DevOnichan/IoT-Based-Water-Quality/README.md

# 🐟 ระบบตรวจวัดคุณภาพน้ำสำหรับบ่อเลี้ยงปลาสลิดด้วยเทคโนโลยี IoT

## 📖 ความเป็นมาของโครงการ
โครงการนี้เริ่มต้นขึ้นเพื่อแก้ปัญหาในพื้นที่จังหวัดสมุทรสงคราม ซึ่งมีการเพาะเลี้ยงปลาสลิดเป็นจำนวนมาก แหล่งน้ำแต่ละบ่อมีสภาพแวดล้อมที่แตกต่างกันและอาจเกิดความผิดปกติ (เช่น ค่าความเป็นกรด-ด่างไม่เหมาะสม หรือมีสารปนเปื้อน) ซึ่งส่งผลกระทบต่อสุขภาพและอัตราการรอดของปลาโดยตรง การเก็บตัวอย่างน้ำไปตรวจที่ห้องปฏิบัติการนั้นใช้เวลานานและมีค่าใช้จ่ายสูง เราจึงได้พัฒนาระบบเทคโนโลยี Internet of Things (IoT) ขึ้นมาเพื่อคอยตรวจจับและแจ้งเตือนค่าคุณภาพน้ำ ช่วยให้เกษตรกรสามารถรับมือและแก้ไขปัญหาได้รวดเร็วขึ้น

## 🛠️ อุปกรณ์ฮาร์ดแวร์ที่ใช้

* **NodeMCU V2 ESP8266:** บอร์ดไมโครคอนโทรลเลอร์พร้อมตัวกระจายสัญญาณ Wi-Fi ทำหน้าที่รับข้อมูลและส่งขึ้นคลาวด์
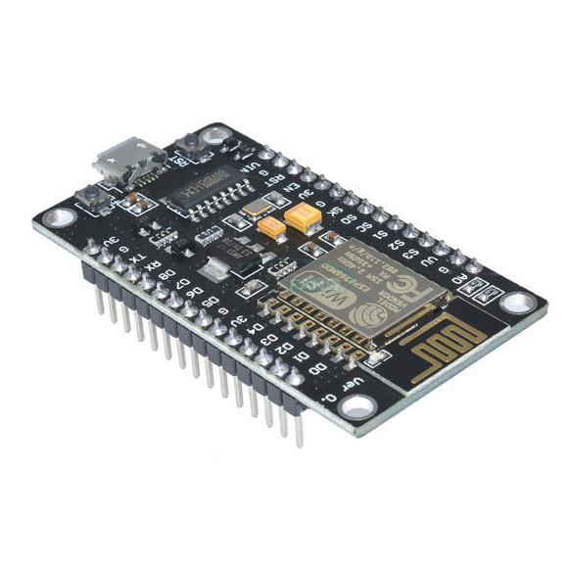
[picture p1: .assets/Hardware/ESP8266.png]
NodeMCU V2 ESP8266
  <details><summary>📸 ดูรูปภาพ</summary></details>

* **Arduino UNO R3:** บอร์ดสำหรับรับค่าจากเซ็นเซอร์แอนะล็อกเพื่อเพิ่มความเสถียรของสัญญาณก่อนส่งต่อ
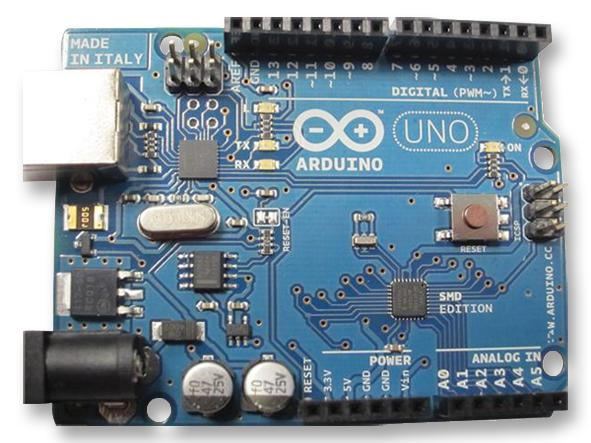
[picture p2: .assets/Hardware/ArduinoUNO.jpg]
Arduino UNO R3
  <details><summary>📸 ดูรูปภาพ</summary></details>

* **Sensor วัดอุณหภูมิในน้ำ (DS18B20):** เซ็นเซอร์ดิจิทัลสำหรับวัดอุณหภูมิของเหลว
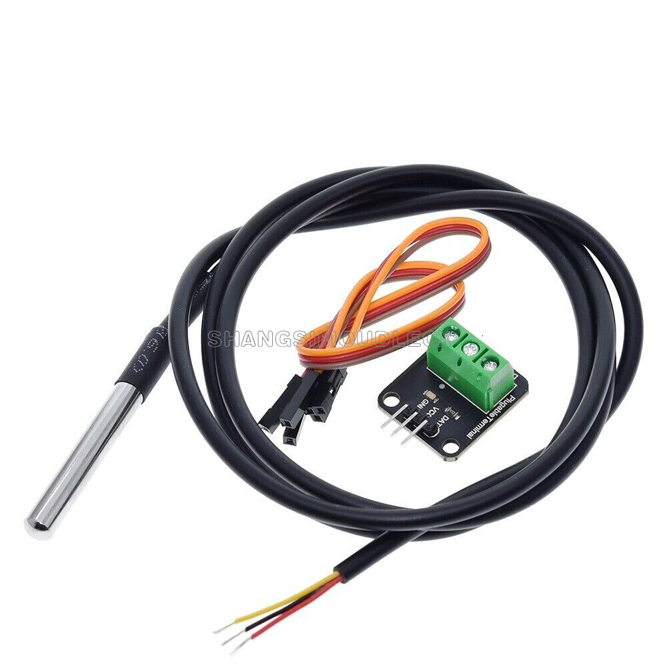
[picture p3: .assets/Hardware/Sensor Temp.jpg]
DS18B20 Temperature Sensor
  <details><summary>📸 ดูรูปภาพ</summary></details>

* **Sensor วัดค่าความขุ่น:** อุปกรณ์สำหรับเช็คปริมาณสารแขวนลอยในน้ำ
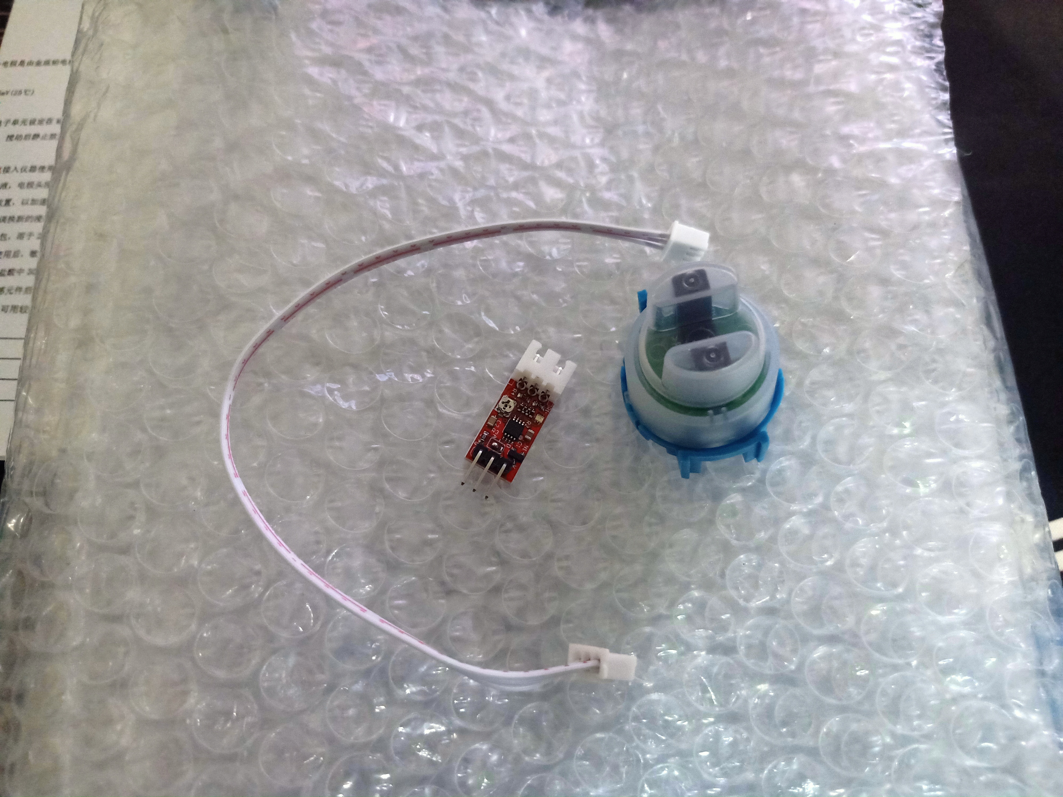
[picture p4: .assets/Hardware/Sensor Turb.jpg]
Turbidity Sensor
  <details><summary>📸 ดูรูปภาพ</summary></details>

* **Sensor วัดค่า TDS:** เซ็นเซอร์ตรวจจับปริมาณของแข็งที่ละลายในน้ำ เพื่อบ่งชี้ความบริสุทธิ์
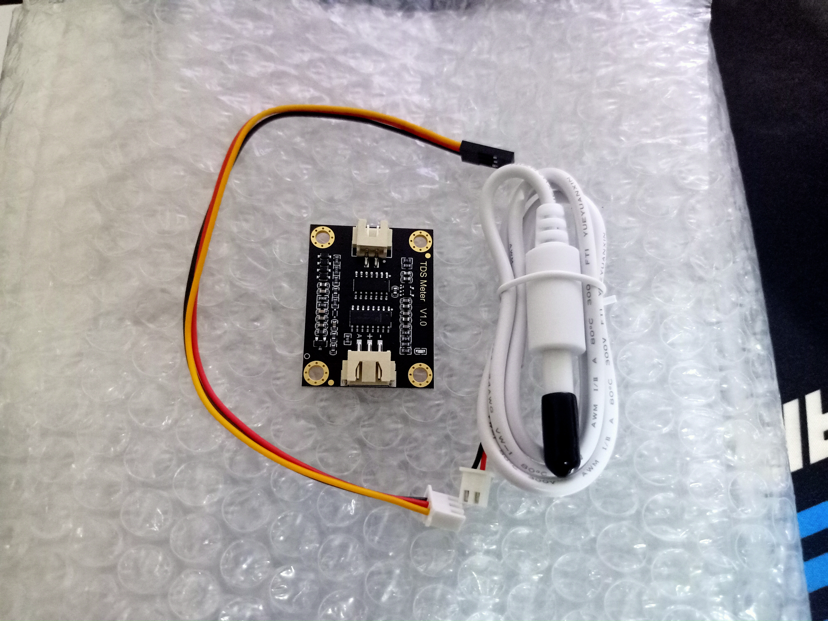
[picture p5: .assets/Hardware/Sensor TDS.jpg]
TDS Sensor
  <details><summary>📸 ดูรูปภาพ</summary></details>

* **Sensor วัดค่า pH:** อุปกรณ์ตรวจสอบระดับความเป็นกรด-ด่างของน้ำ
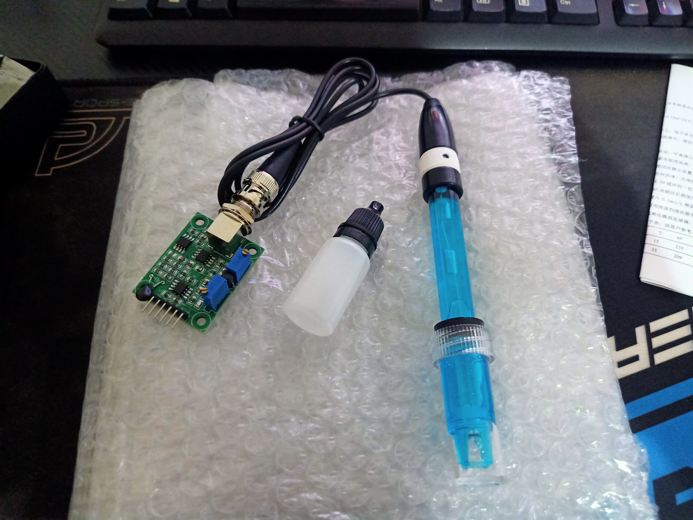
[picture p6: .assets/Hardware/Sensor pH.jpg]
pH Sensor
  <details><summary>📸 ดูรูปภาพ</summary></details>

* **Sensor วัดค่า ORP:** เซ็นเซอร์วัดศักย์ไฟฟ้าเพื่อดูการปนเปื้อนและปฏิกิริยาในน้ำ
  <details><summary>📸 ดูรูปภาพ</summary>ORP Sensor</details>

* **โมดูลสื่อสารไร้สาย 4G LTE Cat 1 (A7670E):** อุปกรณ์รับส่งข้อมูลความเร็วสูงผ่านเครือข่ายมือถือ
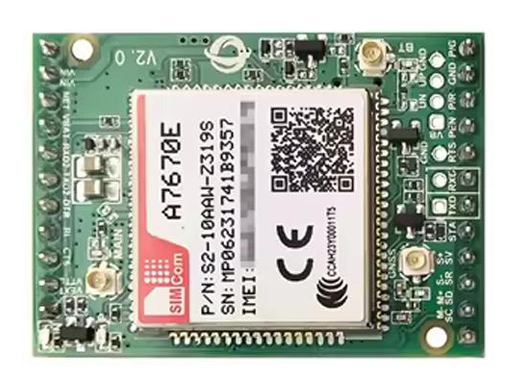
[picture p7: .assets/Hardware/A7670E.png]
4G LTE Cat 1 A7670E
  <details><summary>📸 ดูรูปภาพ</summary></details>

* **แผงโซล่าเซลล์ (10 วัตต์):** แหล่งกำเนิดพลังงานแสงอาทิตย์สำหรับจ่ายไฟให้ระบบ
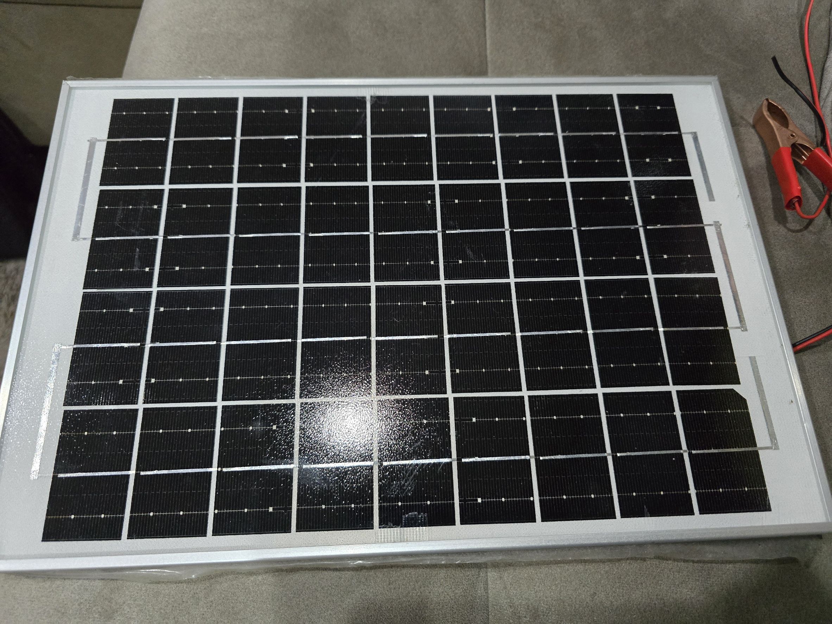
[picture p8: .assets/Hardware/Solar Panel.jpg]
10W Solar Panel
  <details><summary>📸 ดูรูปภาพ</summary></details>

* **เครื่องควบคุมการชาร์จ (PWM):** อุปกรณ์ควบคุมและจัดการกระแสไฟจากแผงโซล่าเซลล์เพื่อชาร์จลงแบตเตอรี่
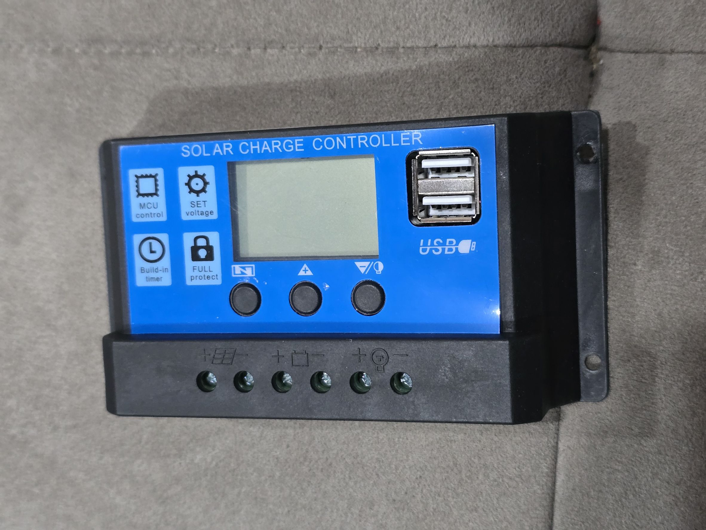
[picture p9: .assets/Hardware/Solar Charge Controllers.jpg]
PWM Solar Charge Controller
  <details><summary>📸 ดูรูปภาพ</summary></details>

---

## 🔌 การทำงานและการต่อวงจร (Circuit & Data Flow)
ระบบมีการแบ่งการประมวลผลเพื่อลดภาระและเพิ่มความเสถียร บอร์ด Arduino จะรับหน้าที่อ่านค่าจากเซ็นเซอร์ pH, ORP และความขุ่น (แอนะล็อก) ส่วน NodeMCU จะอ่านค่า TDS และอุณหภูมิโดยตรง

หลังจาก Arduino รวบรวมค่าได้ จะส่งข้อมูลต่อไปให้ NodeMCU ทางพอร์ต Serial (TX-RX) เมื่อประมวลผลความถูกต้องเสร็จสิ้น NodeMCU จะส่งข้อมูลทั้งหมดขึ้นเซิร์ฟเวอร์ผ่านโมดูล 4G (A7670E) และเข้าสู่โหมดประหยัดพลังงาน (Sleep Mode) อัตโนมัติเพื่อลดการใช้ไฟจากโซล่าเซลล์

<div align="center">
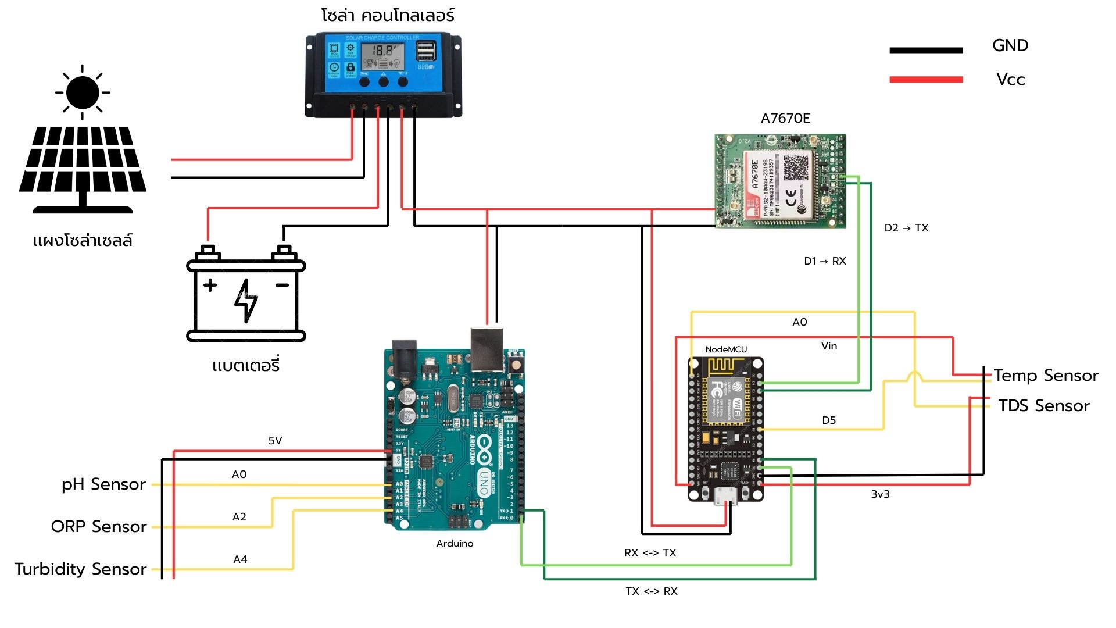
[picture p10: .assets/circuit.jpg]
IoT Circuit Diagram
  
  <p><em>ภาพรวมการต่อวงจรของระบบ IoT วัดคุณภาพน้ำ</em></p>
</div>

---

## 📱 การออกแบบส่วนเชื่อมต่อผู้ใช้ (User Interface)
ระบบนี้ถูกออกแบบมาเพื่อให้ผู้ใช้งานดูข้อมูลและรับการแจ้งเตือนได้สะดวกที่สุด:
1. **Cloud Connection:** ข้อมูลจากบอร์ดจะถูกส่งขึ้นไปเก็บบนแพลตฟอร์มคลาวด์ของ Blynk
2. **Database System:** เราใช้งาน Google Apps Script (GAS) เพื่อดึงข้อมูลจาก Blynk มาบันทึกลง Google Sheet อย่างเป็นระบบ
3. **LINE Official Account:** แจ้งเตือนและติดต่อกับผู้ใช้งานผ่าน LINE Messaging API ทำให้สามารถส่งรายงานสถานะน้ำ แจ้งเตือนเมื่อค่าผิดปกติ และมีเมนูสำหรับการควบคุม

<div align="center">
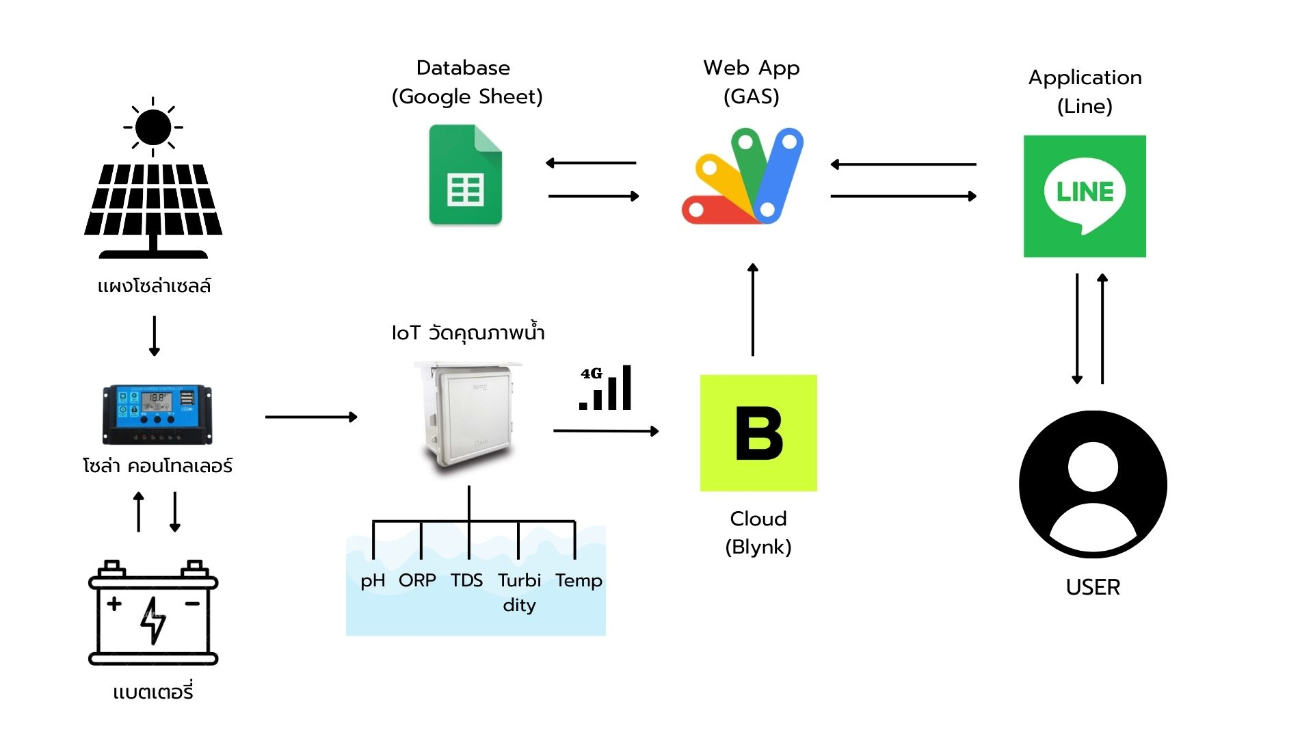
[picture p11: .assets/User Interface Design.jpg]
User Interface and LINE Application Integration
  
  <p><em>โครงสร้างส่วนเชื่อมต่อระหว่าง Cloud, Database และ LINE Application</em></p>
</div>

## 🟢 การตั้งค่า Datastreams บน Blynk Platform

<div align="center">
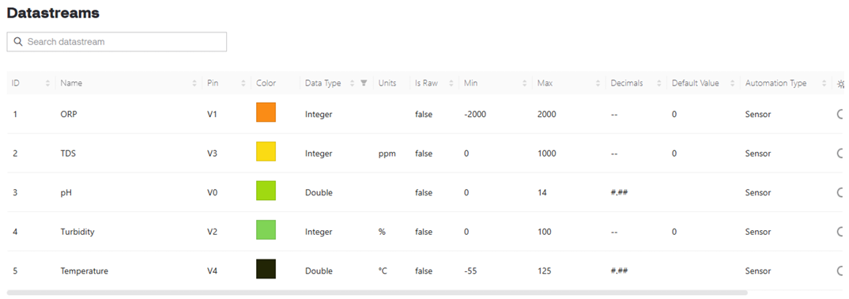
[picture p12: .assets/Blynk Setting.png]
  
  <p><em>การตั้งค่า Datastreams บน Blynk Platform</em></p>
</div>

---

### 💬 หน้าจอแสดงผลและ Rich Menu (LINE OA)
ผู้ใช้งานสามารถโต้ตอบกับระบบผ่านแอปพลิเคชัน LINE ได้โดยตรง โดยสามารถเพิ่มหน้าต่าง Rich Menu ให้ผู้ใช้กดเพื่อขอดูรายงานคุณภาพน้ำ ณ ปัจจุบัน หรือตั้งค่าเปิด-ปิดการแจ้งเตือนเตือนภัยได้อย่างรวดเร็ว

**RICH MENU ต้องออกเเบบเอง**

<div align="center">
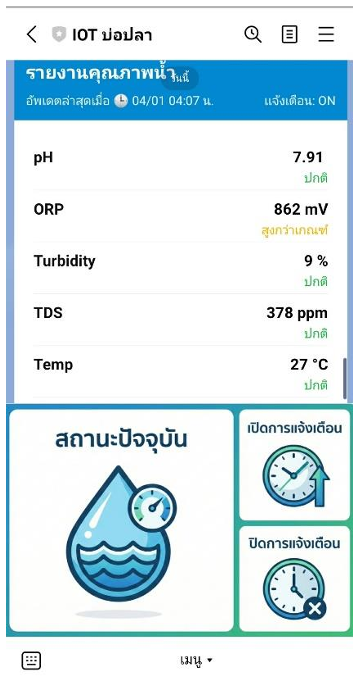
[picture p13: .assets/rich menu.png]
LINE Rich Menu
  
  <p><em>หน้าต่าง Rich Menu สำหรับให้ผู้ใช้งานโต้ตอบกับระบบผ่าน LINE</em></p>
</div>

---

## ระบบฐานข้อมูล (Database)
เราใช้ **Google Sheets** ทำหน้าที่เป็นฐานข้อมูล (Database) หลักในการจัดเก็บประวัติคุณภาพน้ำ (Log) ซึ่งช่วยให้เกษตรกรสามารถเข้ามาดูข้อมูลย้อนหลัง หรือนำข้อมูลไปวิเคราะห์ต่อยอดได้อย่างง่ายดาย โดยจะบันทึกค่าพารามิเตอร์ต่างๆ เช่น เวลา (Timestamp), pH, ORP, Turbidity, TDS และ Temperature

<div align="center">
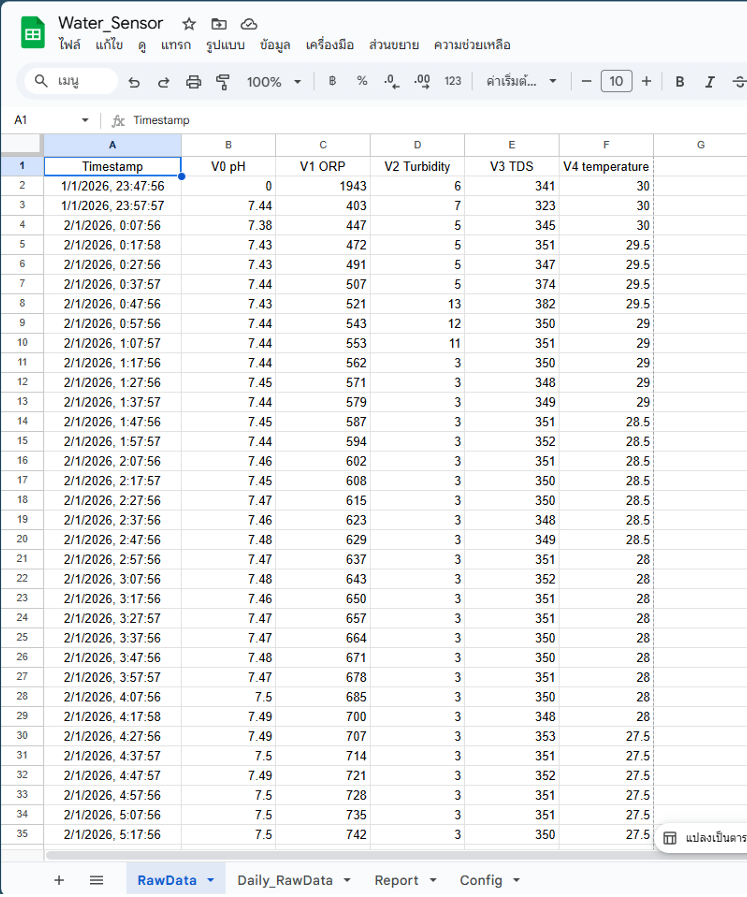
[picture p14: .assets/Google Sheet.png]
Google Sheet Database
  
  <p><em>ตัวอย่างการจัดเก็บข้อมูลคุณภาพน้ำลงใน Google Sheet</em></p>
</div>

---

## การติดตั้งและนำ Google Apps Script ไปใช้งาน
ใน Repository นี้จะมีโฟลเดอร์ชื่อ `Google App Script` ซึ่งเก็บไฟล์โค้ดนามสกุล `.gs` สำหรับควบคุมการทำงานฝั่งเซิร์ฟเวอร์ (`Config.gs`, `FlexMessage.gs`, `Logic.gs`, `Main.gs`, `Utility.gs`) คุณสามารถนำโค้ดไปติดตั้งได้ตามขั้นตอนดังนี้:

1. เปิด Google Sheet ที่คุณต้องการใช้เป็นฐานข้อมูล
2. ไปที่เมนู **ส่วนขยาย (Extensions) > Apps Script**
3. สร้างไฟล์สคริปต์ใหม่ให้ตรงกับชื่อไฟล์ในโฟลเดอร์ และคัดลอกโค้ดจากใน Repo ลงไปให้ครบทุกไฟล์
4. ไปที่ไฟล์ `Config.gs` เพื่ออัปเดตข้อมูลตัวแปรต่างๆ ให้เป็นของคุณเอง (เช่น ใส่ค่า LINE Channel Access Token, URL/Token ของฝั่ง Blynk และ Spreadsheet ID)
5. เมื่อตั้งค่าเสร็จแล้ว ให้กดปุ่ม **การทำให้ใช้งานได้ (Deploy) > การทำให้ใช้งานได้รายการใหม่ (New deployment)**
6. เลือกประเภทการติดตั้งเป็น **เว็บแอป (Web App)** และตั้งค่าสิทธิ์การเข้าถึงเป็น "ทุกคน (Anyone)"
7. คัดลอก **URL ของเว็บแอป (Webhook URL)** ที่ได้ ไปใส่ในระบบของ LINE Developers Console ในส่วนของ Messaging API เพื่อให้ระบบ LINE สามารถสื่อสารกับ Google Sheet ของเราได้

**สําคัญ : ต้องตั้งค่า Trigger ในส่วน `Main.gs` เพื่อดึงค่าจาก Blynk**

## เหตุผลว่าทําไมจึงไม่ส่งข้อมูลเข้า Google Sheet เลย
สือเนื่องมาจากการติดตั้ง IoT ติดตั้งในพื้นที่ ที่ไม่มี WiFi เข้าถึง จึงใช้งานในส่วนของ A7670E ที่สามารถเสียบซิมมือถือ เพื่อเข้าถึง Internet ได้

ในระบบ IoT เดิมมีแนวคิดส่งข้อมูลจากอุปกรณ์ไปยัง Google Sheet โดยตรงผ่าน HTTPS แต่พบว่าการเชื่อมต่อจาก MicroController มีโอกาสเกิดปัญหา เช่น การ handshake ของ SSL/TLS ใช้ทรัพยากรสูง ทำให้บางครั้งส่งข้อมูลไม่สำเร็จหรือหลุดระหว่างทาง 

จึงปรับสถาปัตยกรรมระบบใหม่ โดยให้อุปกรณ์ส่งข้อมูลผ่าน HTTP ไปยัง Blynk ก่อน เนื่องจากมีความเสถียรและเหมาะกับอุปกรณ์ IoT มากกว่า จากนั้นใช้ Google Apps Script ดึงข้อมูลจาก Blynk API มาเก็บลง Google Sheet แทน
