DevOnichan/IoT-Based-Water-Quality/.assets/Hardware/Solar Panel Specification.jpg

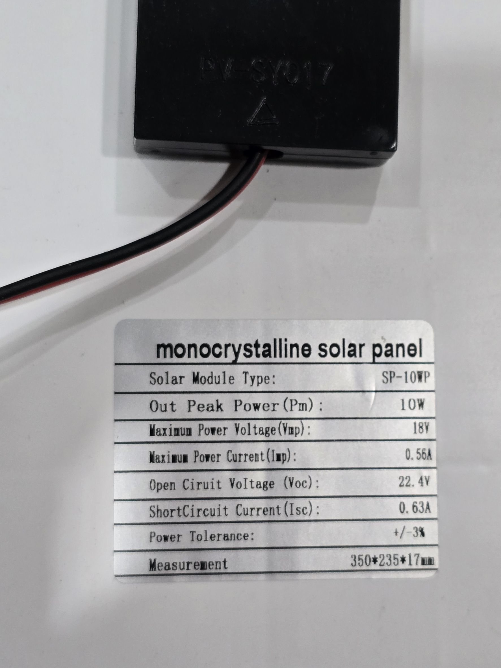
.assets/Hardware/Solar Panel Specification.jpg
