DevOnichan/IoT-Based-Water-Quality/(commit log)

2026-05-22 Revise README with project and hardware details
    Updated the README to include project details, hardware components, circuit design, and user interface design for the IoT water quality monitoring system.
2026-05-22 Rename Senrosr Temp.jpg to Sensor Temp.jpg
2026-05-22 Update Blynk auth token to placeholder
    Replaced the Blynk authentication token with a placeholder.
    [NodeMCU_A7670E.ino]
2026-05-22 Add configuration settings for Google App Script
    This file contains configuration settings for Google App Script, including access tokens, sheet IDs, and default sensor values.
2026-05-22 Add sensor health check and admin command functions
    Implement sensor health check and admin command handling.
